Pichot06/SAEPlante/Photo/IMG_6828.jpeg

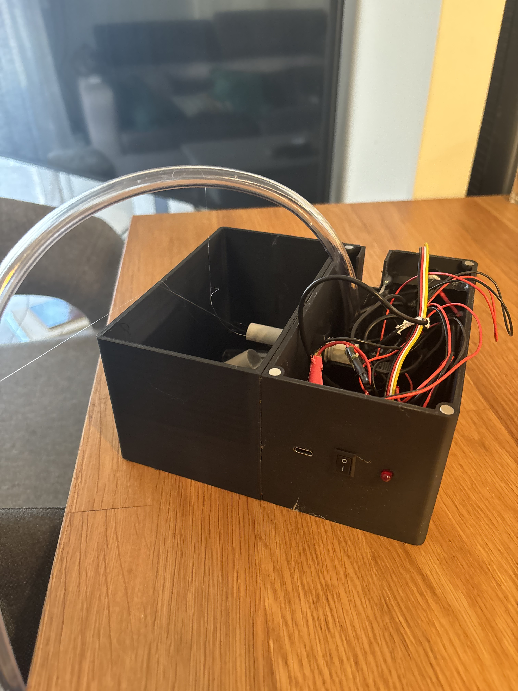
Photo/IMG_6828.jpeg
