Pichot06/SAEPlante/Livrable/SOUTENANCE PLANTMANAGER.pptx

## Votre assistant intelligent pour une gestion parfaite de vos plantes

GOMES Thomas
PICHOT Alexandre

## Sommaire

- Architecture du projet
- Développement Matériel
  - Organisation
  - Tests capteurs unitaires
  - Carte plante
  - Boitier plante
  - Boitier pompe
- Développement Logiciel
  - Script python
  - Base de données
  - Serveur Node.js
  - Interface web

## Architecture

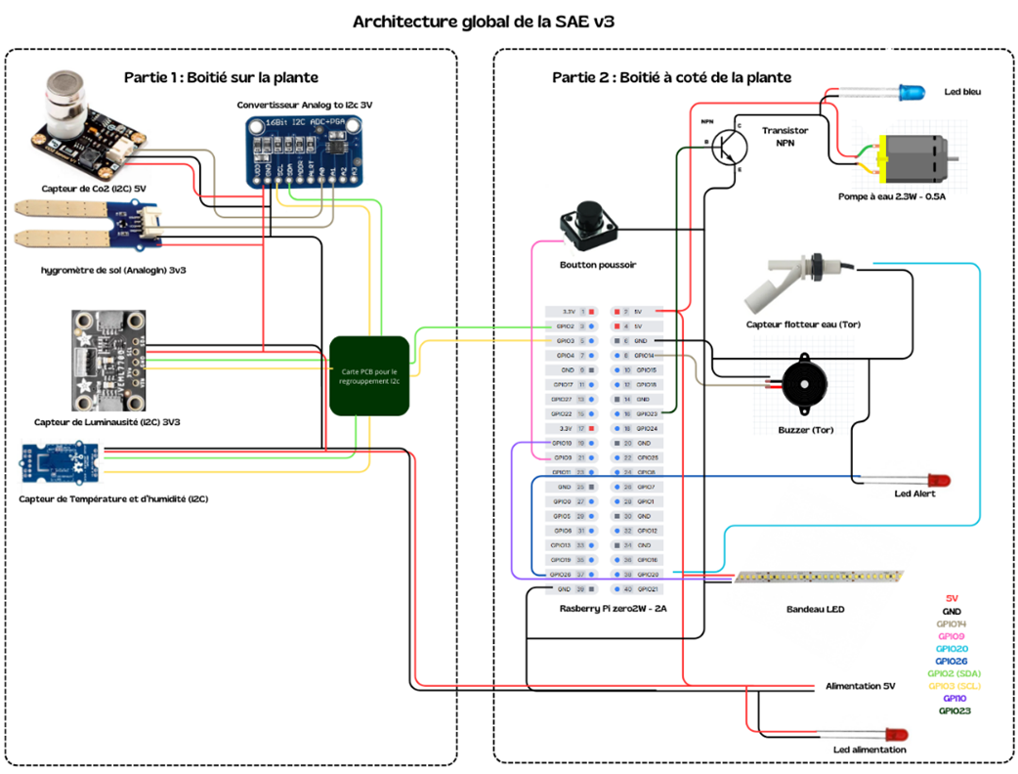
[picture p3: figure]

## ORGANISATION

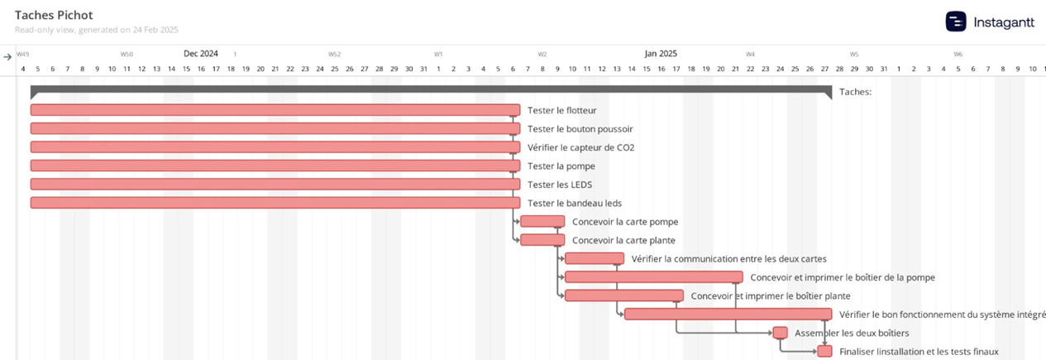
[picture p4: figure]

## Tests capteurs unitaires

## Carte Pompe

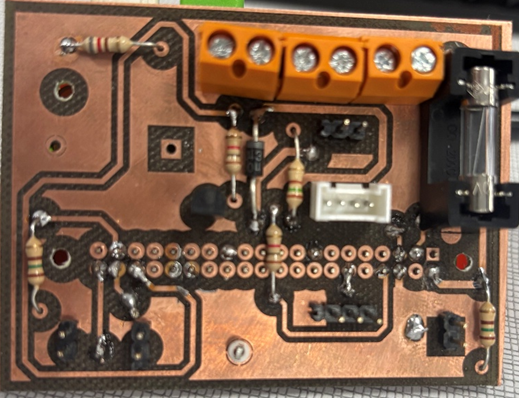
[picture p5: figure]
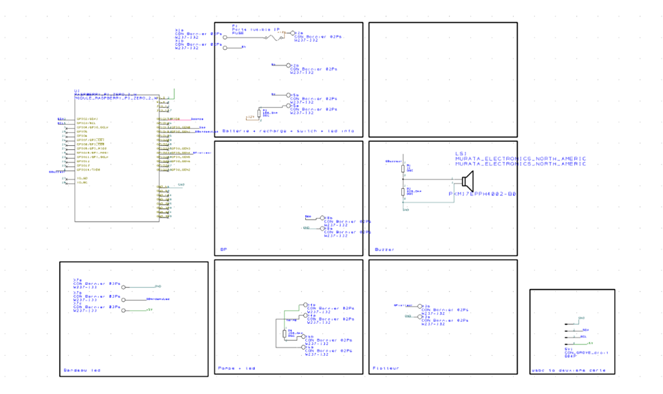
[picture p6: figure]

## Développement Matériel - Boitier plante

- Boite plante

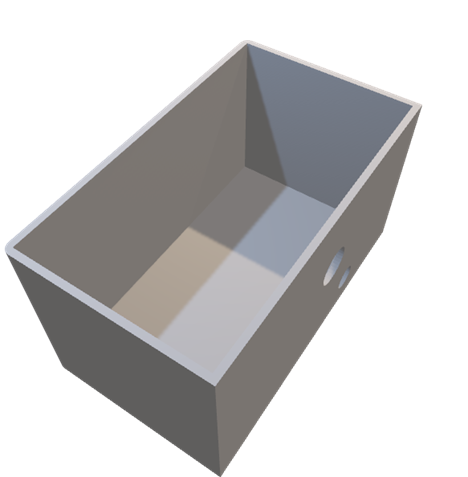
[picture p7: figure]
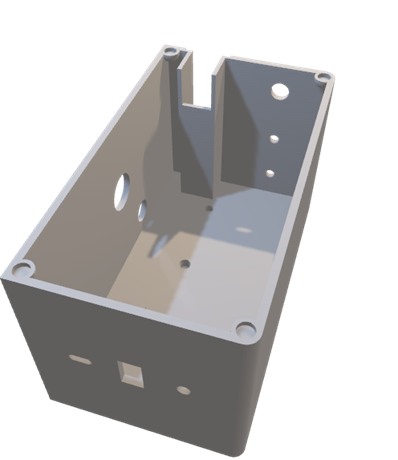
[picture p8: figure]
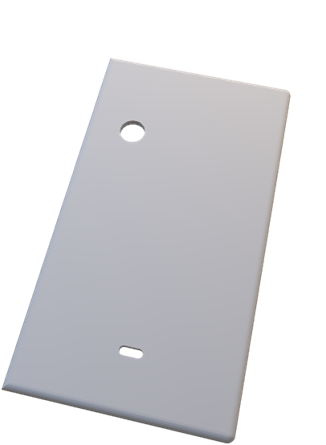
[picture p9: figure]

## Développement Matériel - Boitier plante

- Boite plante

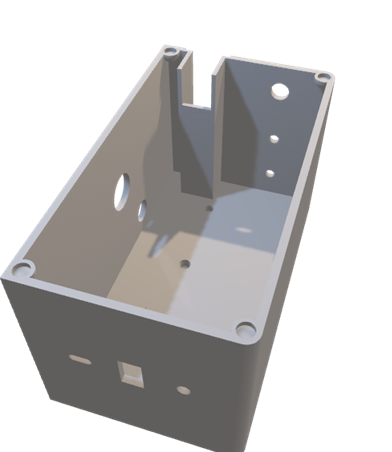
[picture p10: figure]

## Développement Matériel - Boitier pompe

  - Boitier pompe

## Développement Logiciel- Script python

Chaque capteur possède sa propre fonction de lecture de données :
- lire_luminosite() : Renvoie la luminosité en lux.
- lire_co2() : Convertit la tension mesurée en concentration de CO₂ (ppm).
- lire_humidite_sol() : Convertit la tension mesurée en humidité du sol (%).
- lire_flotteur() : Vérifie si le réservoir est vide ou plein.
- lire_bouton_poussoir() : Vérifie si l'utilisateur appuie sur le bouton.

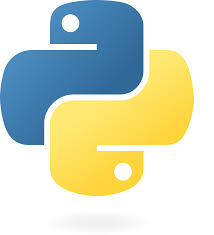
[picture p11: figure]

Chaque capteur possède sa propre fonction de lecture de données :
- lire_luminosite() : Renvoie la luminosité en lux.
- lire_co2() : Convertit la tension mesurée en concentration de CO₂ (ppm).
- lire_humidite_sol() : Convertit la tension mesurée en humidité du sol (%).
- lire_flotteur() : Vérifie si le réservoir est vide ou plein.
- lire_bouton_poussoir() : Vérifie si l'utilisateur appuie sur le bouton.

## Développement Logiciel- Base de données

  - Base de données : Gestion des données & configurations environnement

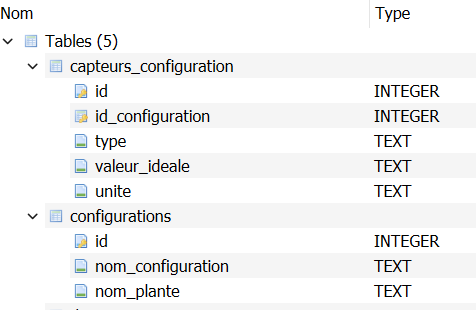
[picture p12: figure]
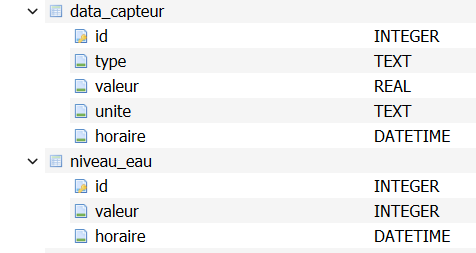
[picture p13: figure]

## Développement Logiciel- Serveur Node.js

- express : Gestion des routes et API.
- express-session : Gestion des sessions utilisateur.
- sqlite3 : Gestion de la base de données
- fs : Gestion des fichiers de configuration.
- nodemailer : Gestion des envois d’alertes par e-mail.
- onoff : Gestion des GPIO pour la pompe.
- ws : Gestion des WebSockets pour mise à jour en temps réel.
- Méthode GET & POST

## Développement Logiciel- Serveur Node.js

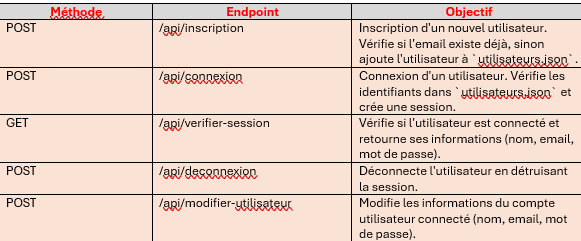
[picture p14: figure]
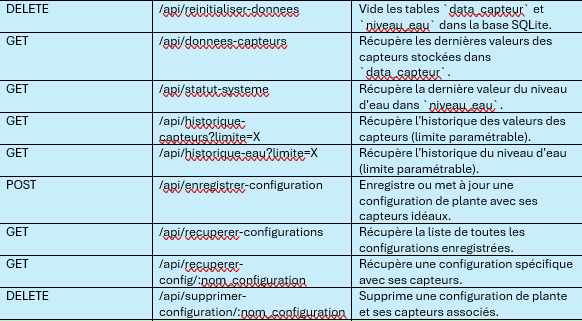
[picture p15: figure]

## Développement Logiciel- INTERFACE WEB

  - INTERFACE WEB

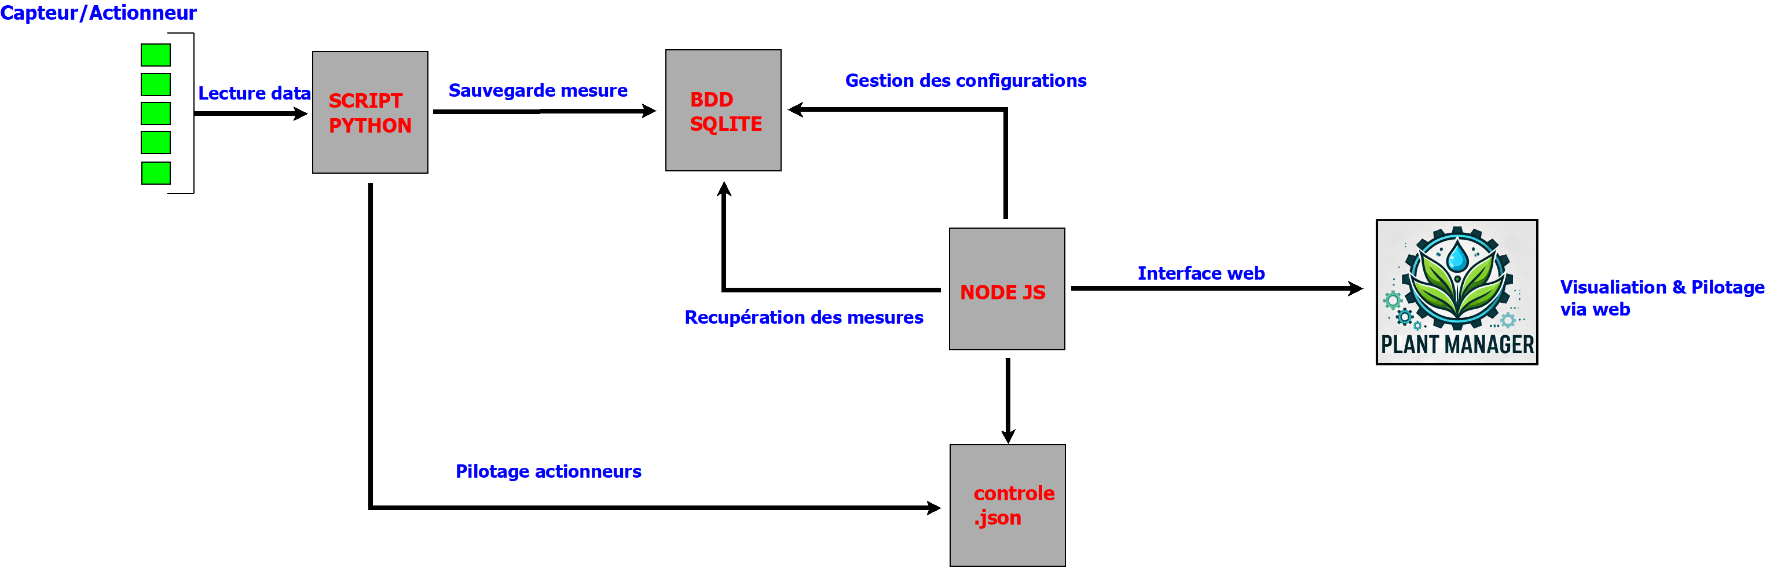
[picture p16: figure]

## RDV SUR LE SITE DE PLANT MANAGER

## Développement Logiciel- RASPBERRy

  - RASPBERRY PI ZERO 2W
  - GPIO, I2C
  - Interconnexions
  - Gestion le serveur web
  - Environnement virtuel python

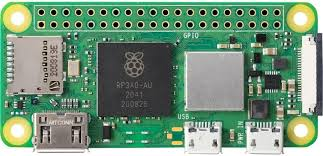
[picture p17: figure]
Raspberry Pi Zero 2 W : Amazon.fr: Informatique

## PlANT MANAGER - CONCLUSION

- conclusion
