Pichot06/SAEPlante/Photo/IMG_6616 3.JPG

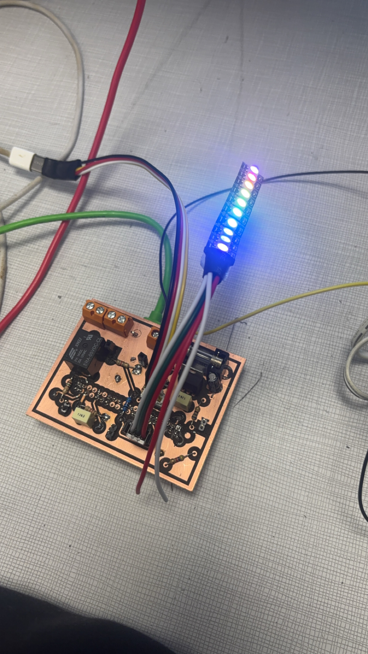
Photo/IMG_6616 3.JPG
