Pichot06/SAEPlante/Photo/IMG_6624 3.PNG

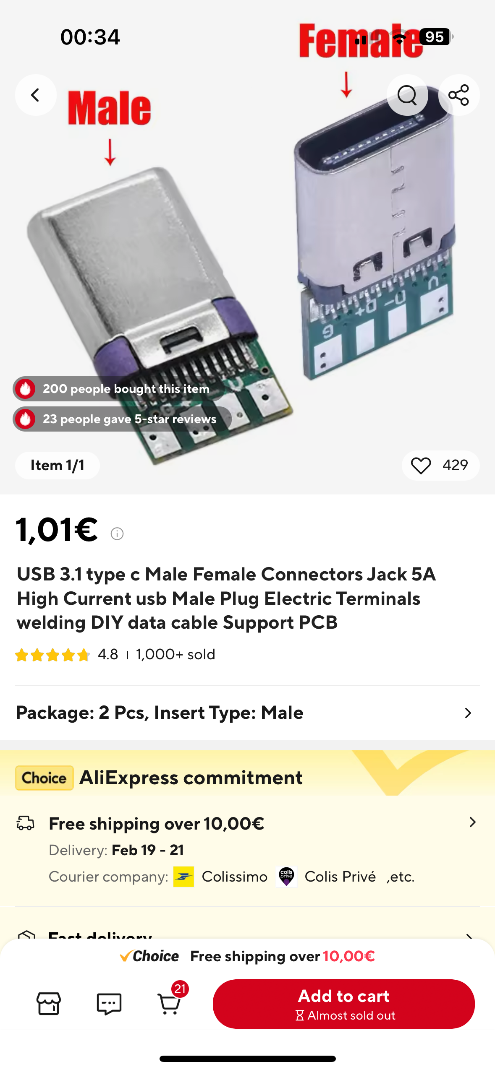
Photo/IMG_6624 3.PNG
