Pichot06/SAEPlante/Photo/IMG_6625 3.jpg

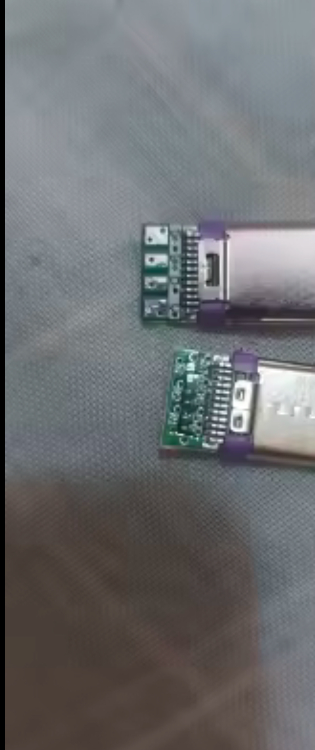
Photo/IMG_6625 3.jpg
