Pichot06/SAEPlante/Photo/IMG_6816.jpeg

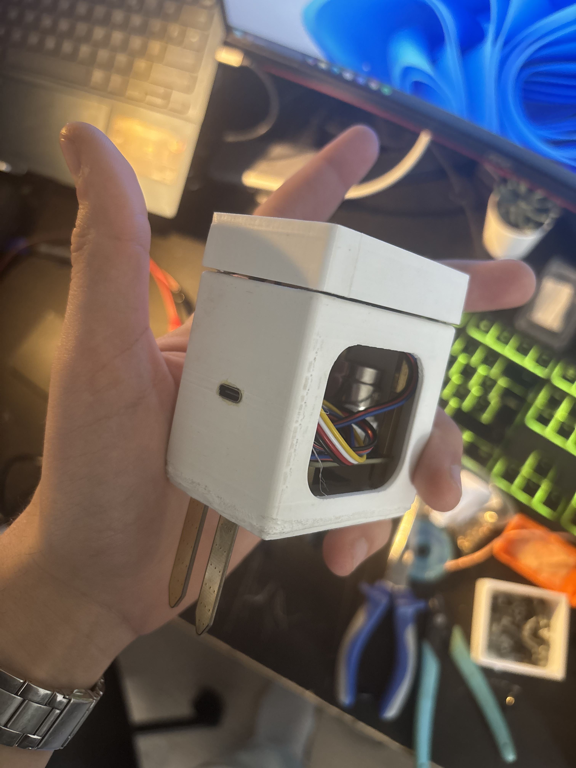
Photo/IMG_6816.jpeg
