Pichot06/SAEPlante/Photo/IMG_6825.jpeg

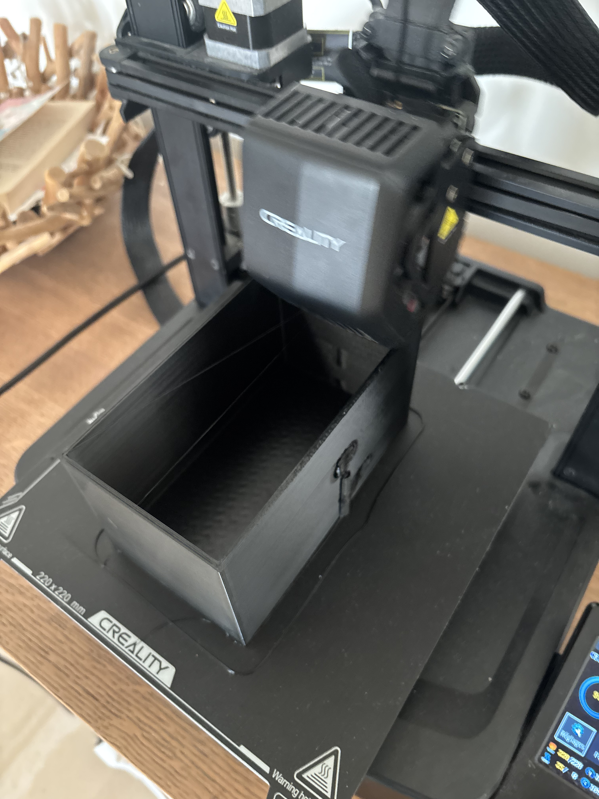
Photo/IMG_6825.jpeg
