Pichot06/SAEPlante/Photo/Rasberry.png

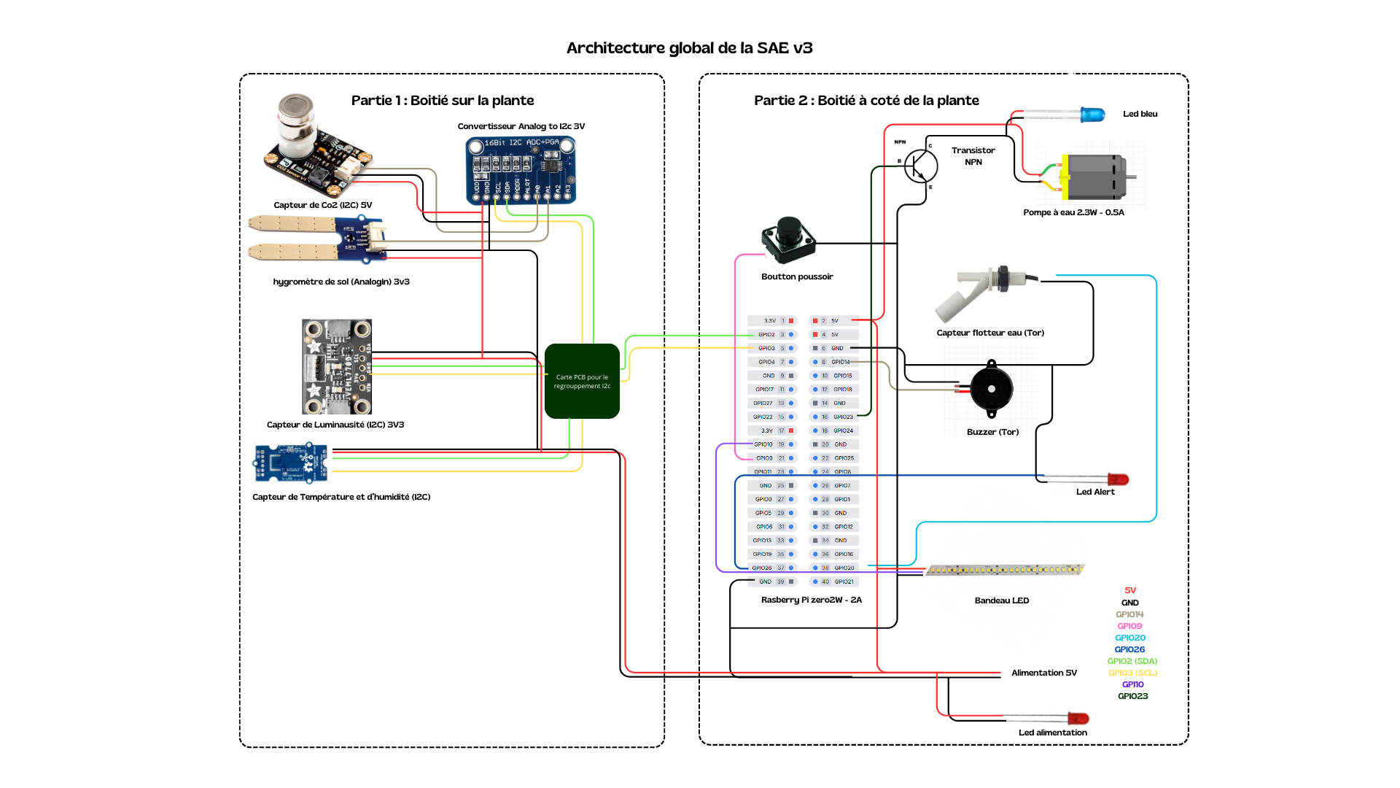
Photo/Rasberry.png
