Pichot06/SAEPlante/Livrable/Prix.xlsx

élements | quantité | prix unitaire | prix tot | lien
USB type c | 1 | 3.88 € | 3.88 € | https://www.aliexpress.com/p/order/detail.html?orderId=3049188231769250
ADS 1115 ADC | 1 | 3.89 € | 3.89 € | https://www.aliexpress.com/p/order/detail.html?orderId=3046306980229250
Ruban Led | 1 | 7.25 € | 7.25 € | https://www.aliexpress.com/p/order/detail.html?orderId=3046641910179250
PLA blanche | 0.3 | 17.99 € | 5.40 € | https://www.amazon.fr/eSUN-Filament-Pr%C3%A9cision-Dimensionnelle-Imprimantes/dp/B0CR1DBBFM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
TPU 95 noir | 0.2 | 15.99 € | 3.20 € | TPU Flexible Filament 1.75mm, JAYO Imprimante 3D Filament TPU Shore 95A, Précision de +/-0,02mm, 0.5KG/500G Bobine, TPU Noir : Amazon.fr: Commerce, Industrie et Science (https://www.amazon.fr/JAYO-Printer-Filament-Dimensional-Accuracy/dp/B08BYKJ22J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)
PLA noir | 0.4 | 17.99 € | 7.20 € | https://www.aliexpress.com/p/order/detail.html?orderId=3039915670719250
pompe | 1 | 5.79 € | 5.79 € | https://www.aliexpress.com/p/order/detail.html?orderId=3039915670739250
cole epoxi bi composants | 1 | 13.00 € | 13.00 € | Amazon
flotteur | 1 | 19.86 € | 19.86 € | 944 pour 'flotteur' | RS (rs-online.com) (https://fr.rs-online.com/web/c/?searchTerm=flotteur)
capteur de Co2 | 1 | 58.90 € | 58.90 € | https://fr.rs-online.com/web/p/kits-de-developpement-pour-capteur/2018095?gb=s
capteur de luminosité | 1 | 4.00 € | 4.00 € | https://fr.aliexpress.com/item/1005005981771097.html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
Entretoise M2 | 0.2 | 3.00 € | 0.60 € | Aliexpress
Raspberry Pi zero 2W | 1 | 20.00 € | 20.00 € | https://fr.aliexpress.com/item/1005005792181612.html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
Cable USB-C to USB-C | 1 | 10.00 € | 10.00 €
 |  | TOTAL : | 162.96 €
