Pichot06/SAEPlante/3D/Boitié_pompe_couvercle.stl

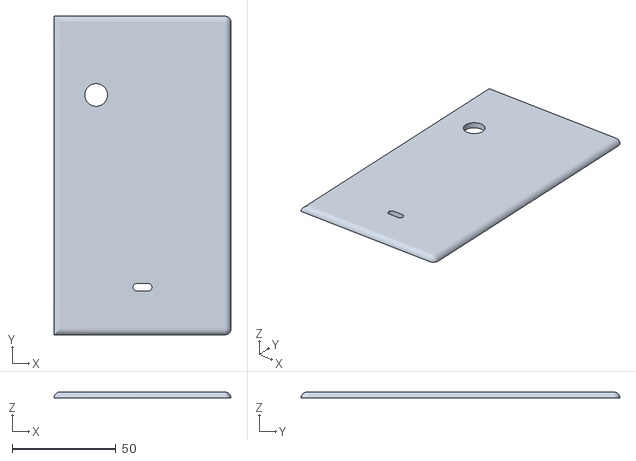
[picture p97: CAD file, 2025-02-27]
3D/Boitié_pompe_couvercle.stl
85.5 x 154.0 x 3.00
