Pichot06/SAEPlante/3D/Boitié_Pompe_Eau.stl

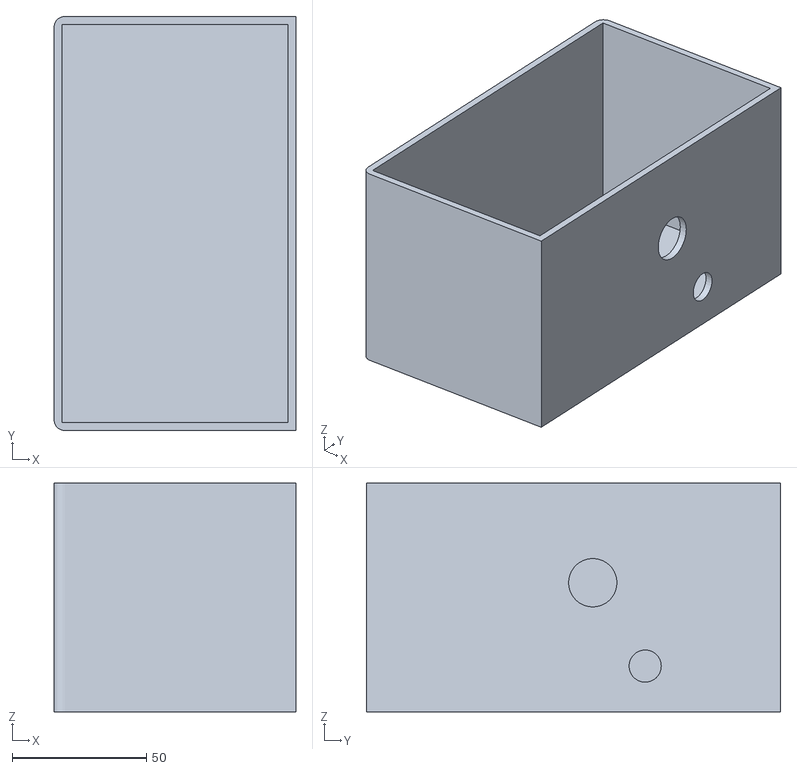
[picture p98: CAD file, 2025-02-27]
3D/Boitié_Pompe_Eau.stl
90.0 x 154.0 x 85.0
