Pichot06/SAEPlante/3D/fetre.stl

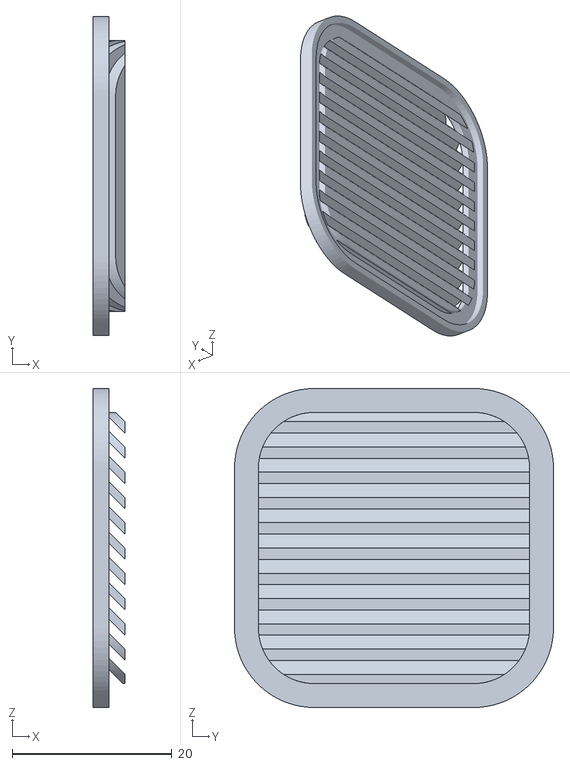
[picture p99: CAD file, 2025-02-27]
3D/fetre.stl
4.00 x 40.0 x 40.0
