Pichot06/SAEPlante/3D/fbnhdegtngngng.stl

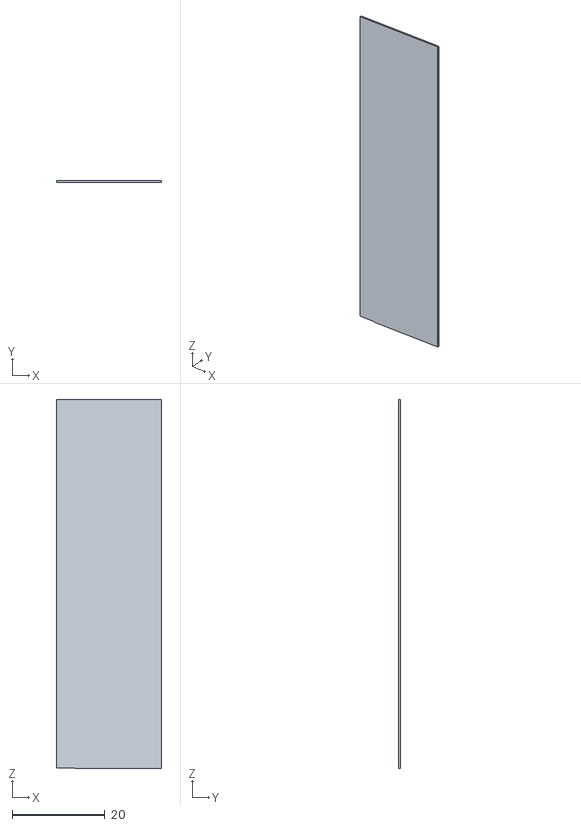
[picture p100: CAD file, 2025-02-27]
3D/fbnhdegtngngng.stl
22.6 x 0.4 x 79.6
