Pichot06/SAEPlante/3D/Boitié_Pompe_BandeauLed.stl

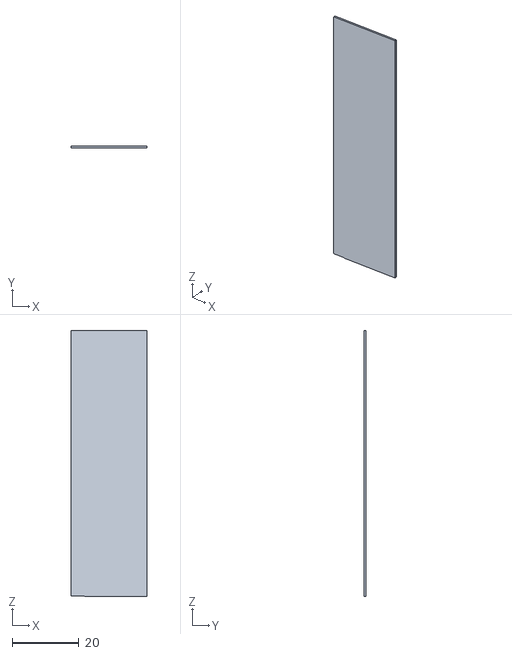
[picture p101: CAD file, 2025-02-25]
3D/Boitié_Pompe_BandeauLed.stl
22.6 x 0.6 x 79.6
