Pichot06/SAEPlante/3D/Boitié_Pompe_plaque_Bandeau.stl

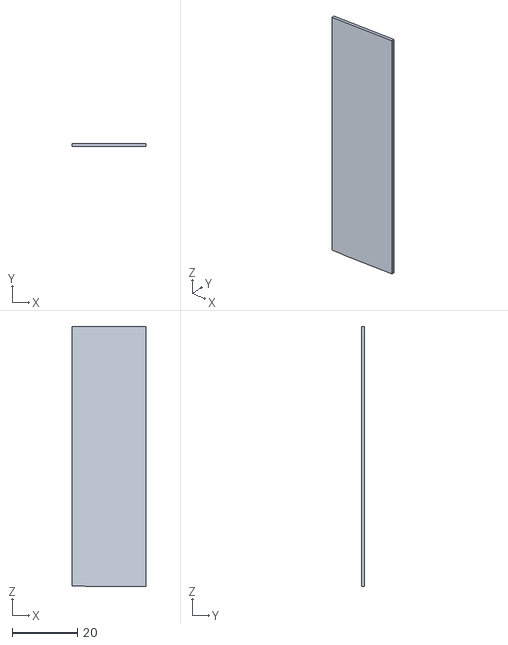
[picture p102: CAD file, 2025-02-19]
3D/Boitié_Pompe_plaque_Bandeau.stl
22.6 x 1.00 x 79.6
