Pichot06/SAEPlante/3D/pour bandeau led.stl

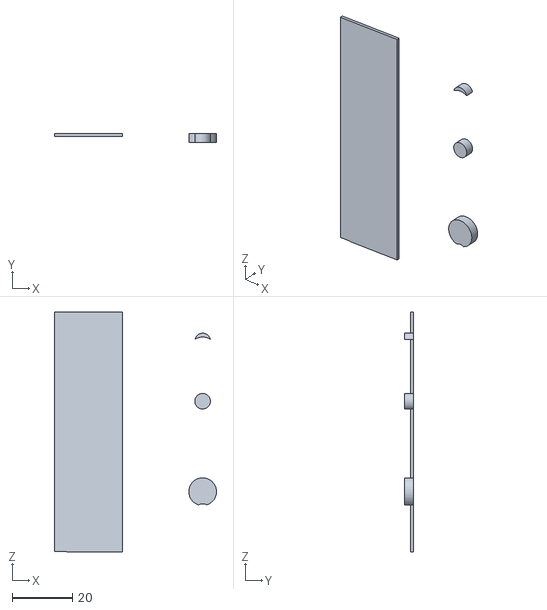
[picture p103: CAD file, 2025-02-19]
3D/pour bandeau led.stl
53.7 x 3.00 x 79.6
