Pichot06/SAEPlante/3D/boitié_pomprV2.stl

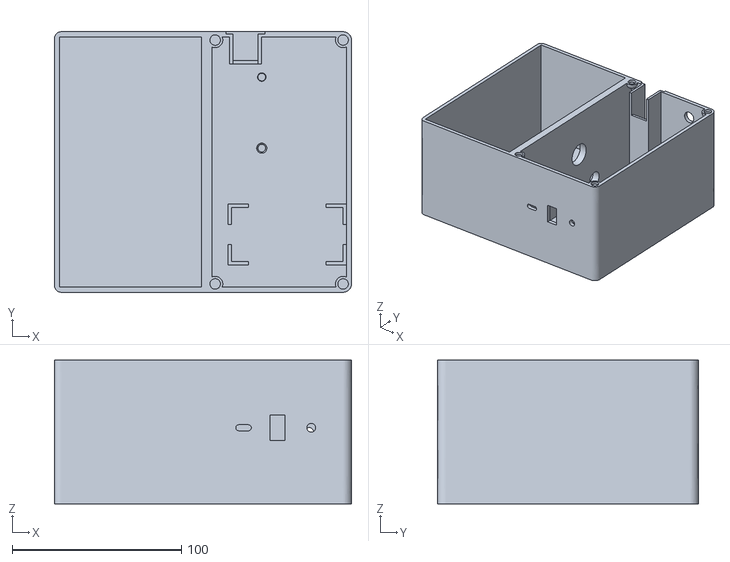
[picture p104: CAD file, 2025-02-19]
3D/boitié_pomprV2.stl
175.5 x 154.0 x 85.0
