Pichot06/SAEPlante/3D/Boitié_Pompe.stl

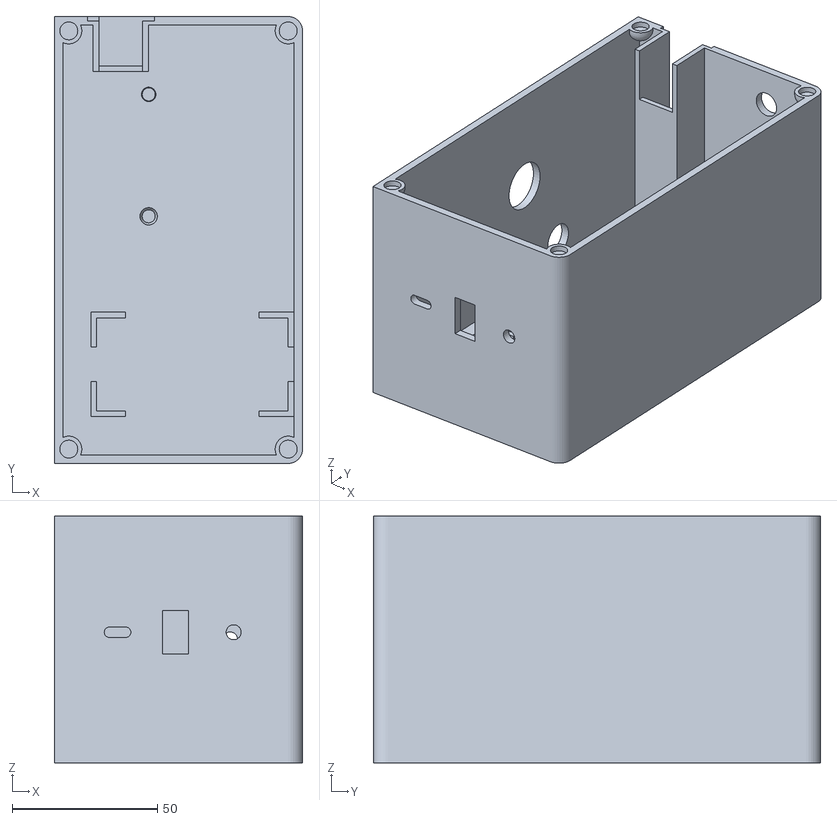
[picture p105: CAD file, 2025-02-19]
3D/Boitié_Pompe.stl
85.5 x 154.0 x 85.0
