Pichot06/SAEPlante/3D/Boitié_Pompe_plaque pour led.stl

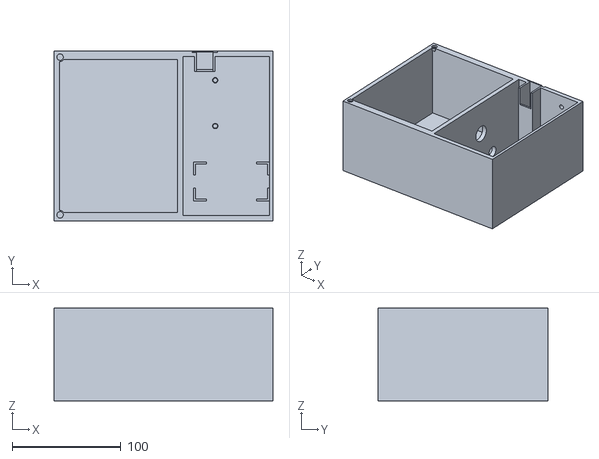
[picture p106: CAD file, 2025-02-19]
3D/Boitié_Pompe_plaque pour led.stl
201.0 x 156.0 x 85.0
