Pichot06/SAEPlante/3D/Boitié_Plante.stl

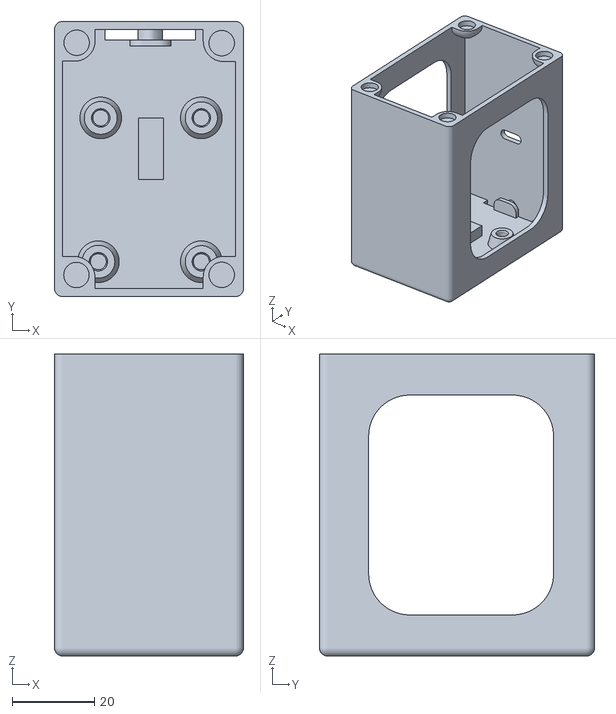
[picture p107: CAD file, 2025-02-19]
3D/Boitié_Plante.stl
46.0 x 67.0 x 73.5
