Pichot06/SAEPlante/3D/Boitié_Plante couvercle.stl

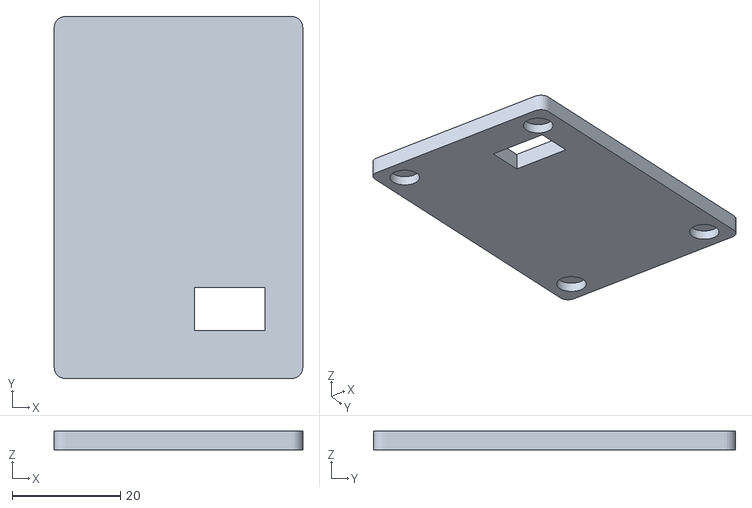
[picture p108: CAD file, 2025-02-19]
3D/Boitié_Plante couvercle.stl
46.0 x 67.0 x 3.50
