Pichot06/SAEPlante/(list of files, cad)

Other CAD files:
3D/chapeau.stl
