Pichot06/SAEPlante/(list of files, drawings)

Other design files:
Carte plante/cartesaeplante2.pcb
Carte Pompe/boitie a cote de plante.pcb
