Pichot06/SAEPlante/(commit log)

2025-02-19 Add files via upload
    Modife des 2 boitié
    [Boitié_Plante couvercle.stl, Boitié_Plante.stl, Boitié_Pompe_plaque pour led.stl]
2025-02-19 Add files via upload
    modifffffff
    [Boitié_Pompe.stl, Boitié_Pompe_couvercle.stl, boitié_pomprV2.stl, chapeau.stl, pour bandeau led.stl, pour bd led.stl]
2025-02-27 Add files via upload
    maj du projet
    [boitie a cote de plante.pcb, boitie a cote de plante.sch, fbnhdegtngngng.stl, fetre.stl]
2025-02-27 Add files via upload
    maj apres soutenance
    [boitie a cote de plante.pcb, boitie a cote de plante.sch, fbnhdegtngngng.stl, fetre.stl]
2025-02-27 Delete Sae Plante directory
    erreur
    [boitie a cote de plante.pcb, boitie a cote de plante.sch, fbnhdegtngngng.stl, fetre.stl]
2025-02-27 PROJET PLANTE FINITOOOOOO
    [Prix.xlsx, cartesaeplante2.pcb, cartesaeplante2.sch]
