Pichot06/SAEPlante/Photo/IMG_6778.jpeg

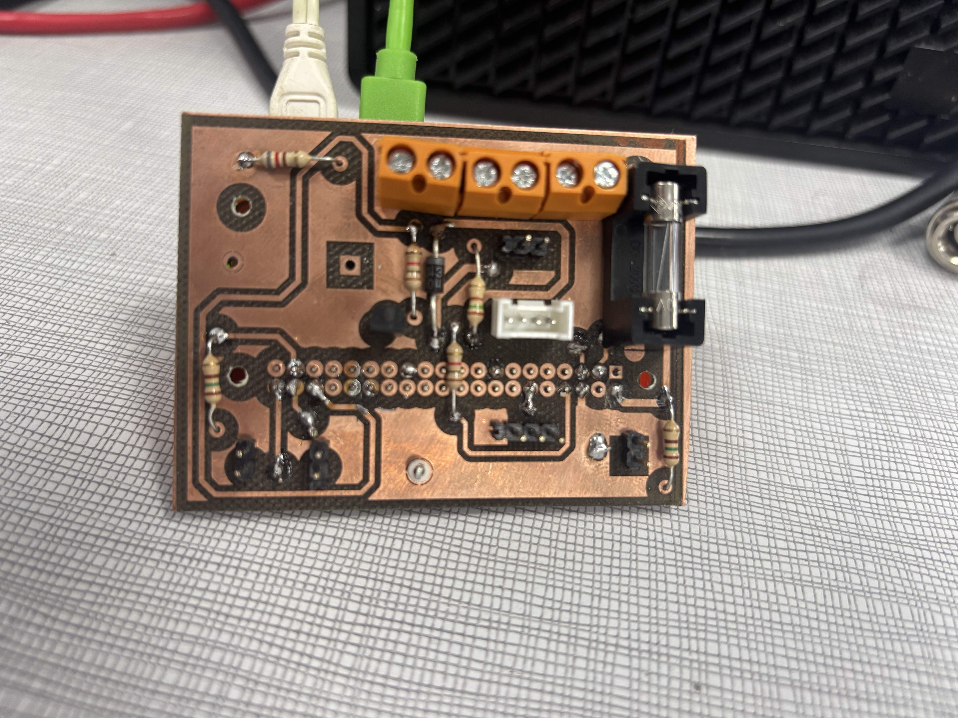
Photo/IMG_6778.jpeg
