Pichot06/SAEPlante/Photo/IMG_6810.jpeg

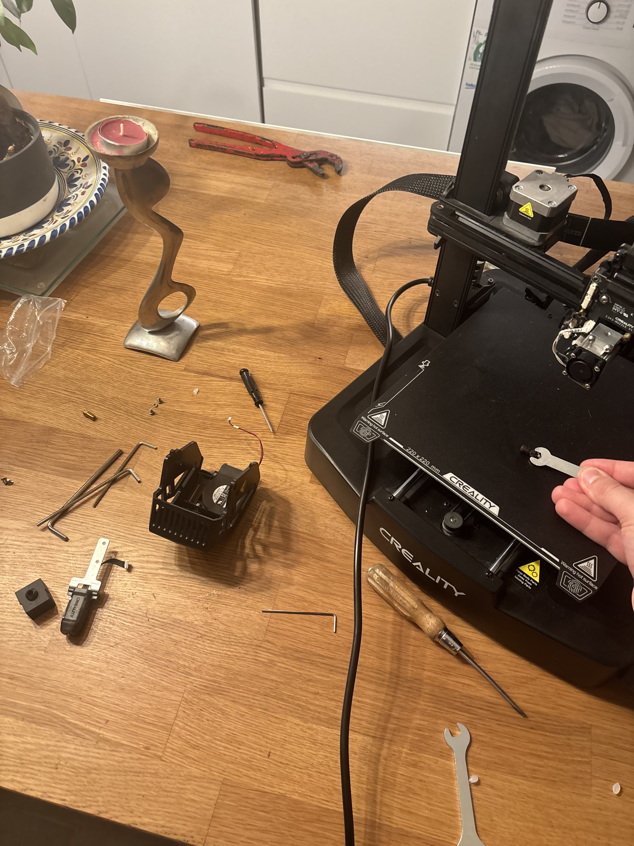
Photo/IMG_6810.jpeg
