Pichot06/SAEPlante/Photo/IMG_6830.jpeg

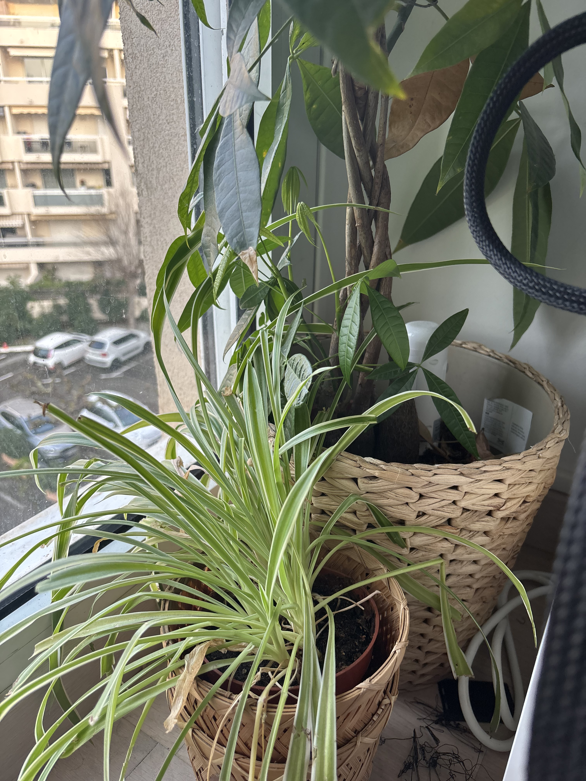
Photo/IMG_6830.jpeg
