Pichot06/SAEPlante/Photo/IMG_6898.jpeg

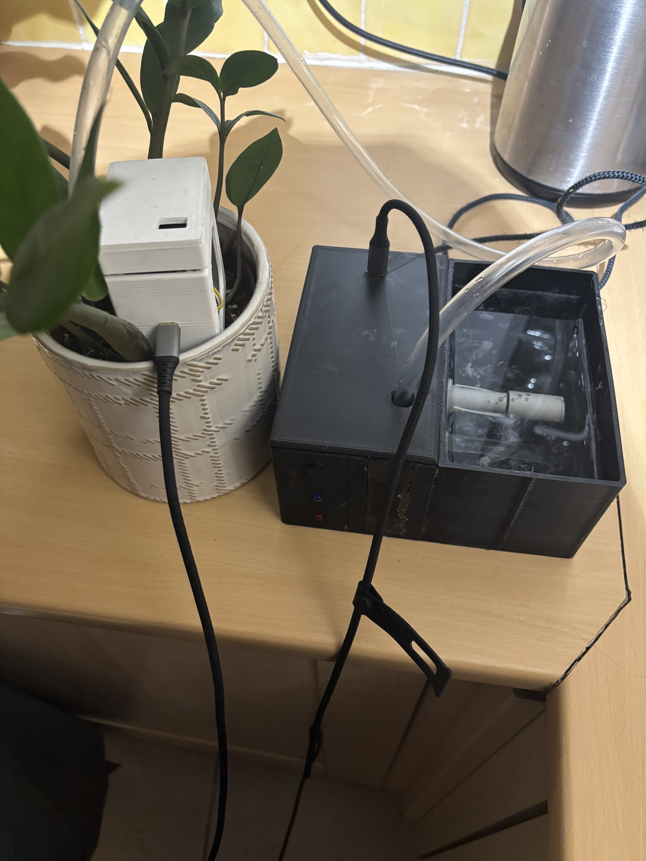
Photo/IMG_6898.jpeg
