Pichot06/SAEPlante/Photo/IMG_6896.jpeg

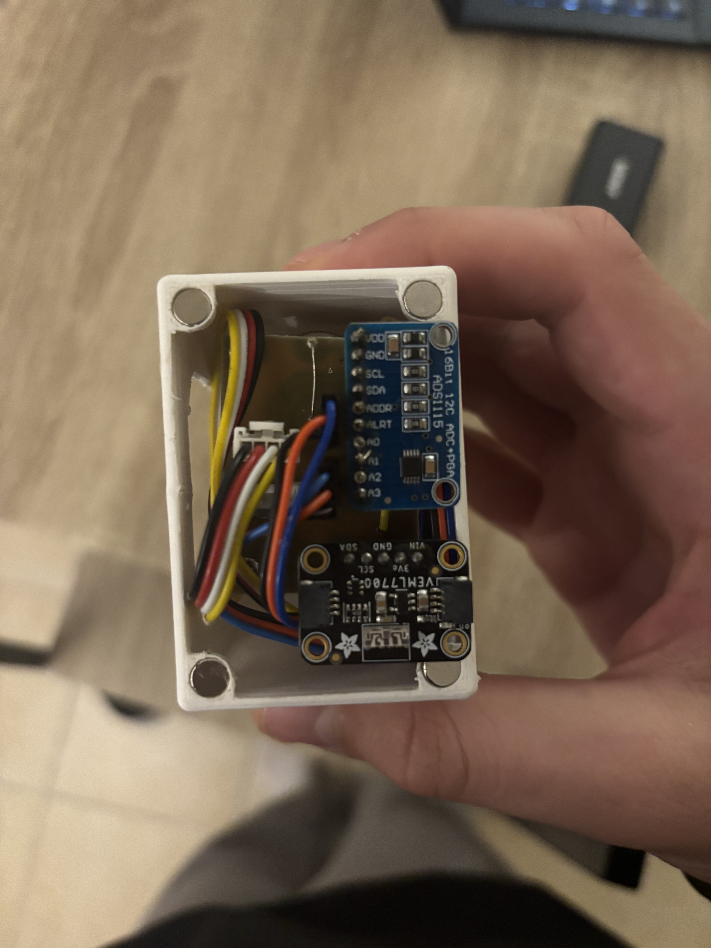
Photo/IMG_6896.jpeg
